Pentalon/KindlePageturner/Pics/Tastenpad und Spannungteiler.jpg

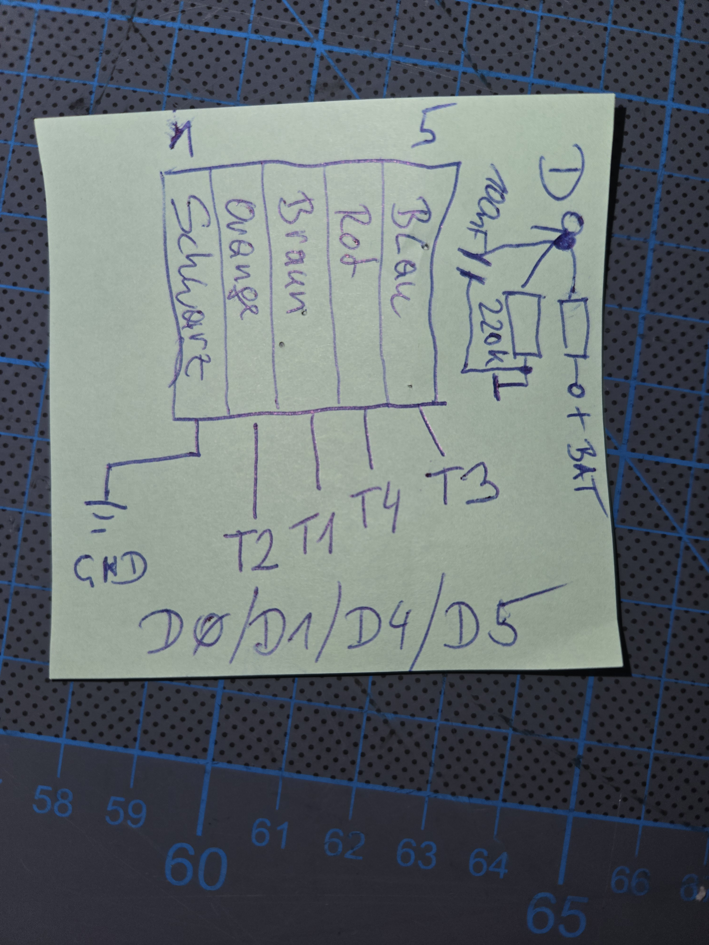
Pics/Tastenpad und Spannungteiler.jpg
