Pentalon/KindlePageturner/Pics/Im Gehäuse.jpg

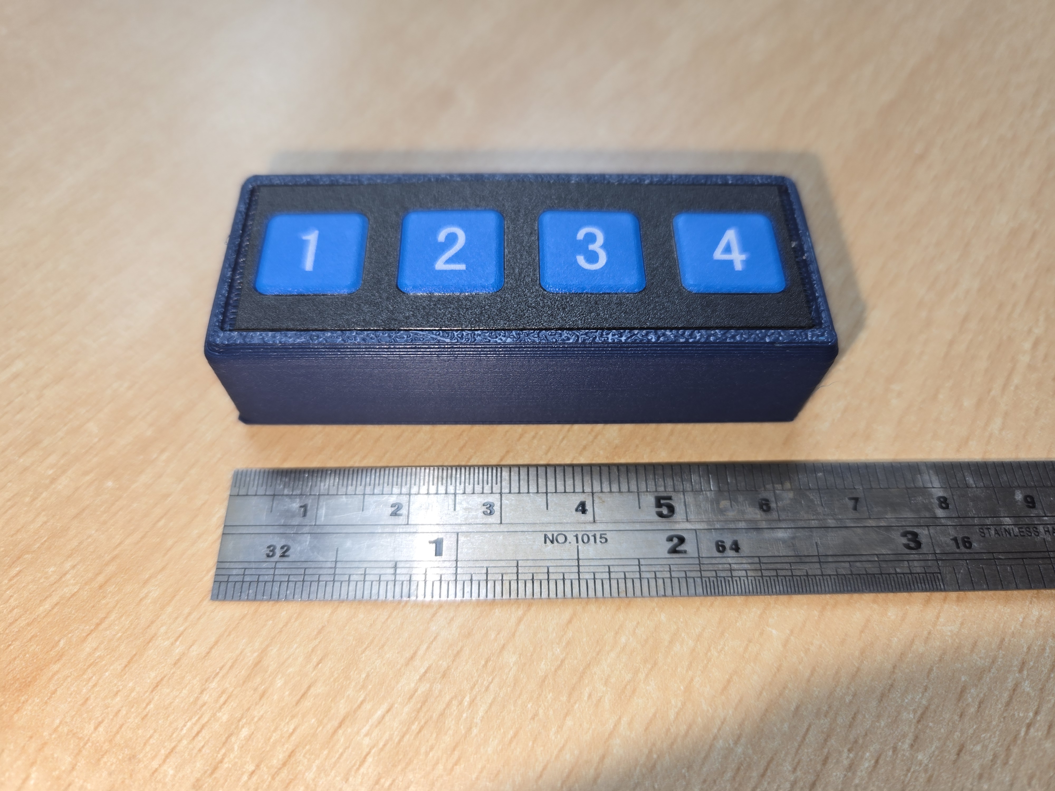
Pics/Im Gehäuse.jpg
