Pentalon/KindlePageturner/Pics/Im Gehäuse 2.jpg

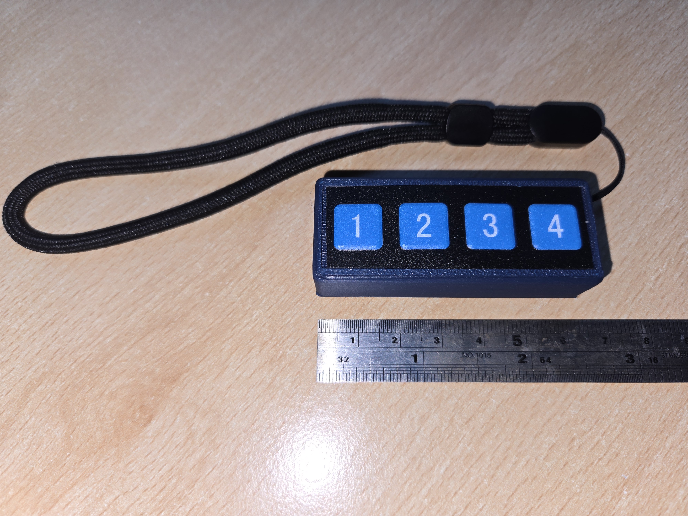
Pics/Im Gehäuse 2.jpg
