Pentalon/KindlePageturner/Pics/Kindle Klick klein (300mA) und gross (3700mA).jpg

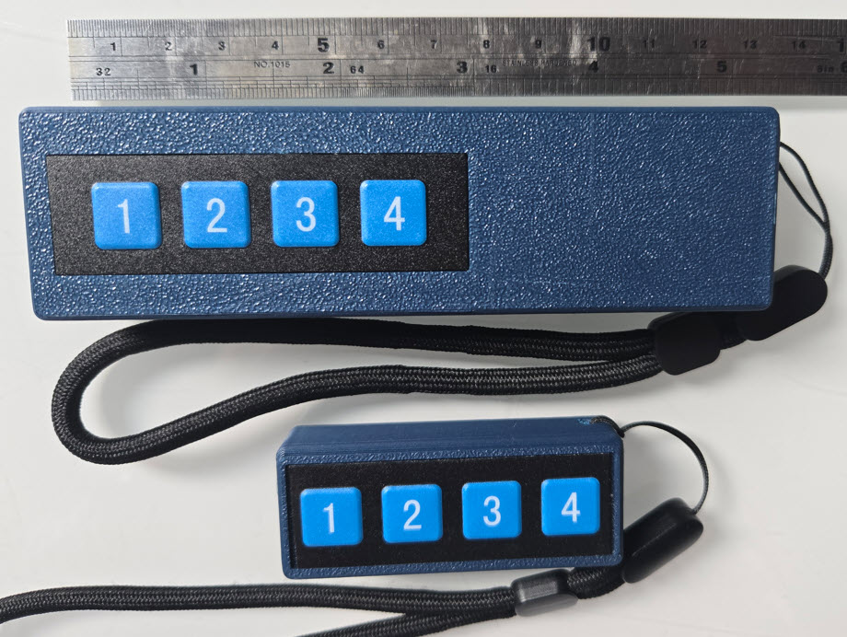
Pics/Kindle Klick klein (300mA) und gross (3700mA).jpg
