Pentalon/KindlePageturner/Pics/Ohne Gehäuse.jpg

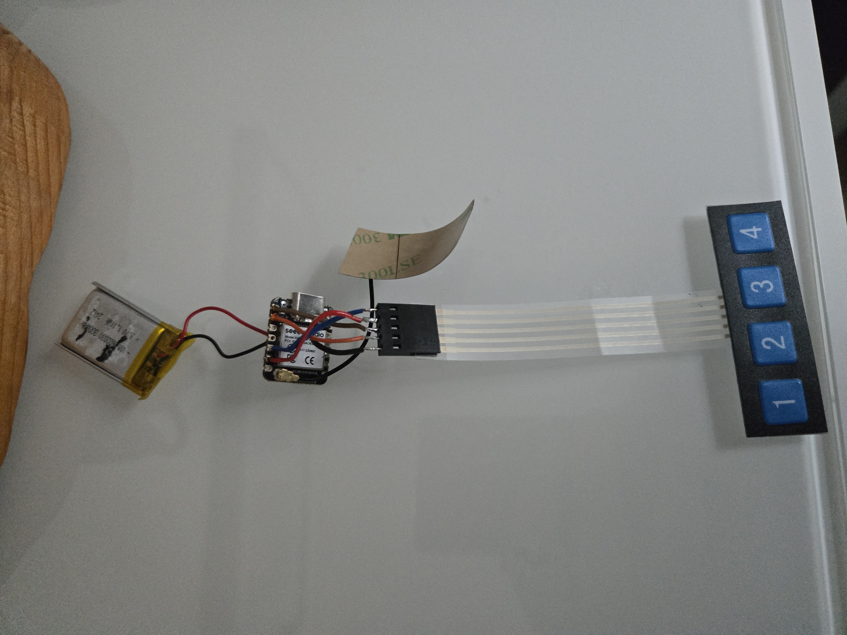
Pics/Ohne Gehäuse.jpg
