Pentalon/KindlePageturner/Pics/Pageturner Schaltplan.jpg

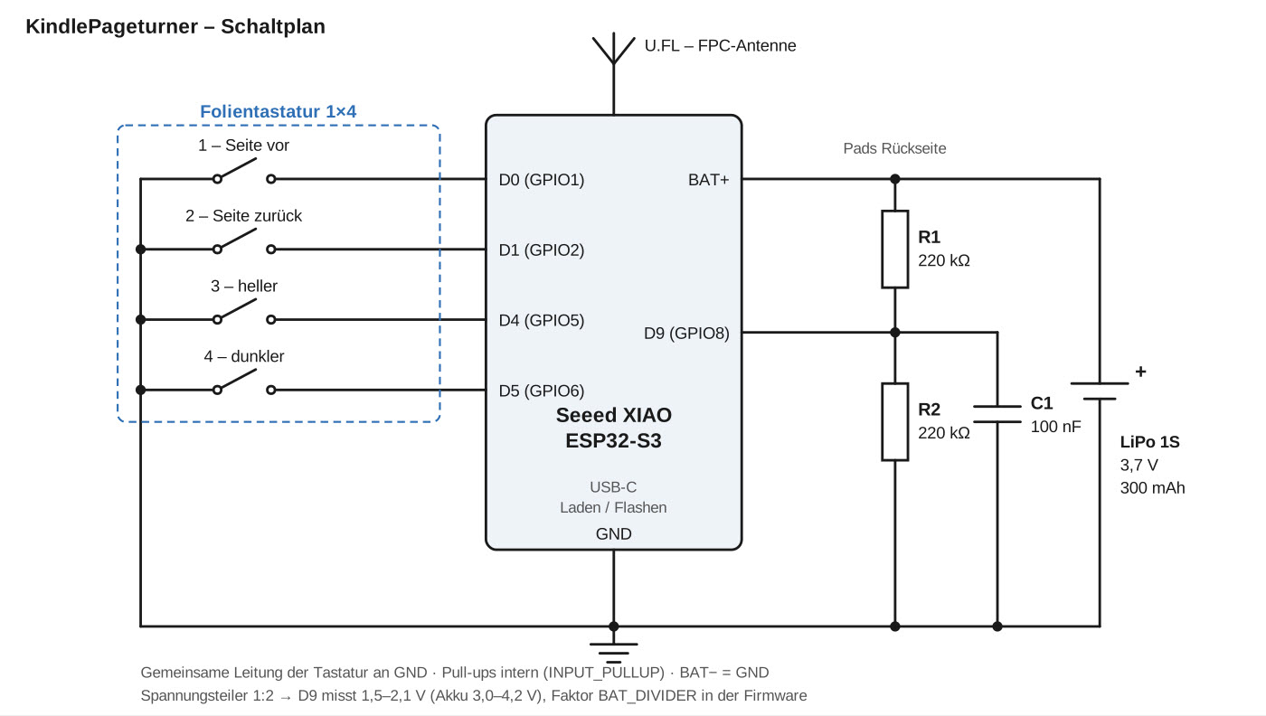
Pics/Pageturner Schaltplan.jpg
