Pentalon/KindlePageturner/Pics/Verkabelung.jpg

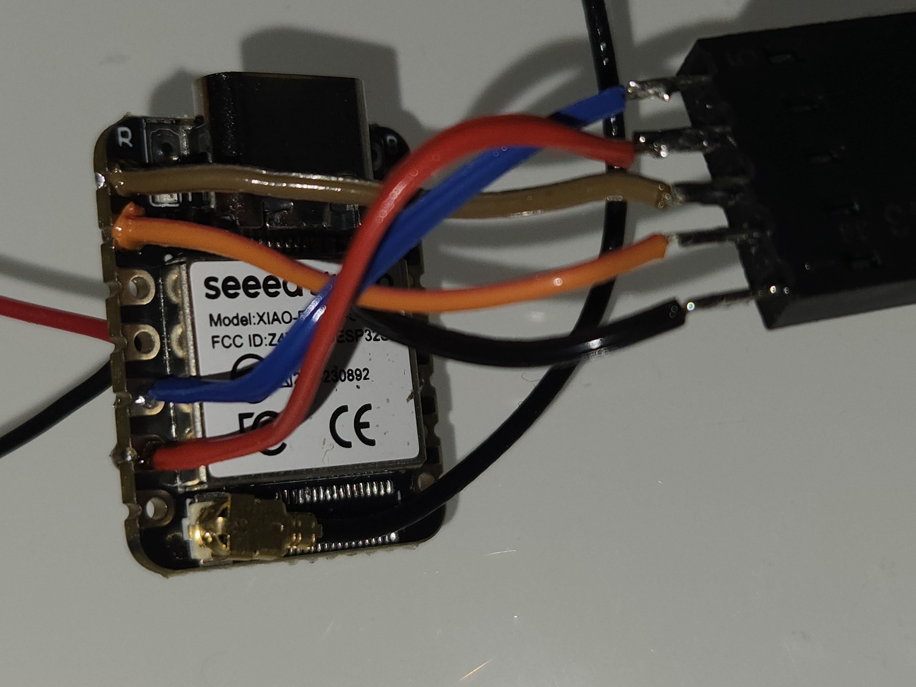
Pics/Verkabelung.jpg
