Pentalon/KindlePageturner/Cad/Kindle Pageturner 3700mA Gehäuse.STEP

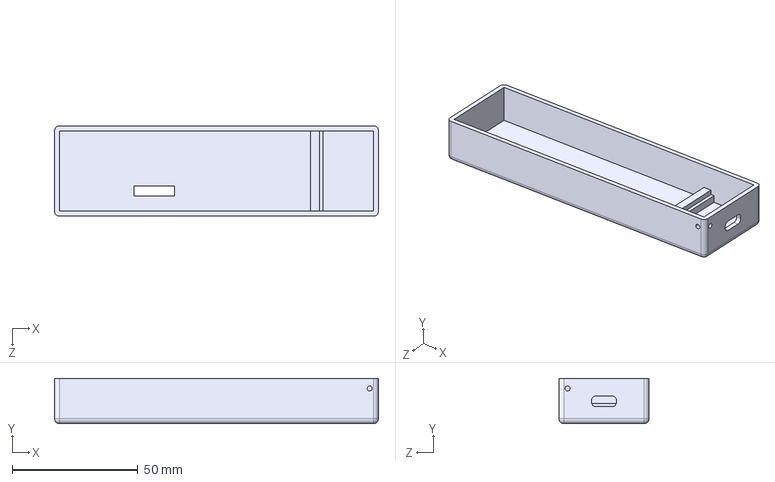
[picture p8: CAD file, 2026-11-07]
Cad/Kindle Pageturner 3700mA Gehäuse.STEP
129.0 x 18.0 x 36.0 mm
