Pentalon/KindlePageturner/Cad/Kindle Pageturner 3700mA.3mf

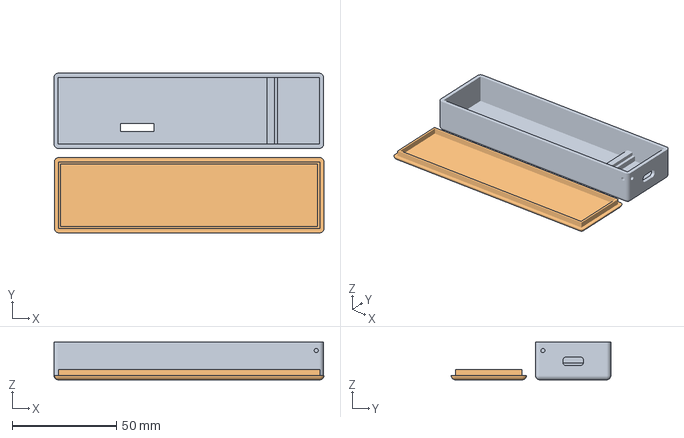
[picture p9: CAD file, 2026-11-07]
Cad/Kindle Pageturner 3700mA.3mf
129.2 x 76.4 x 18.0 mm
Kindle Pageturner 3700mA Deckel
