Pentalon/KindlePageturner/Cad/Kindle Pageturner 3700mA Deckel.STEP

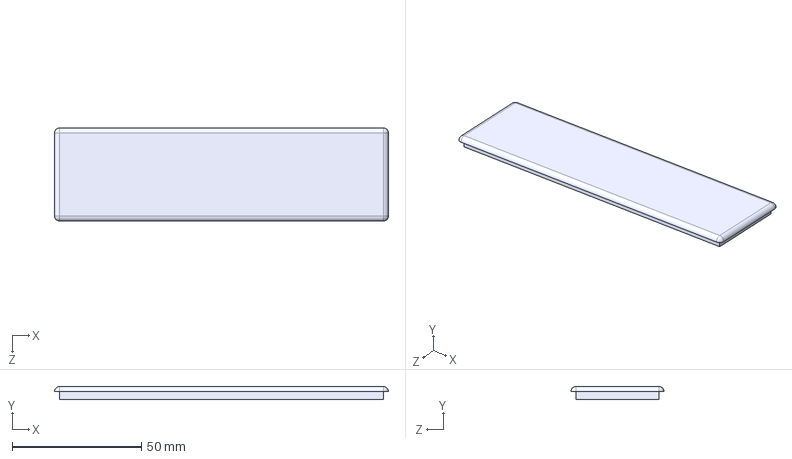
[picture p10: CAD file, 2026-11-07]
Cad/Kindle Pageturner 3700mA Deckel.STEP
129.0 x 5.00 x 36.0 mm
