Pentalon/KindlePageturner/Cad/Kindle Pageturner 300mA.3mf

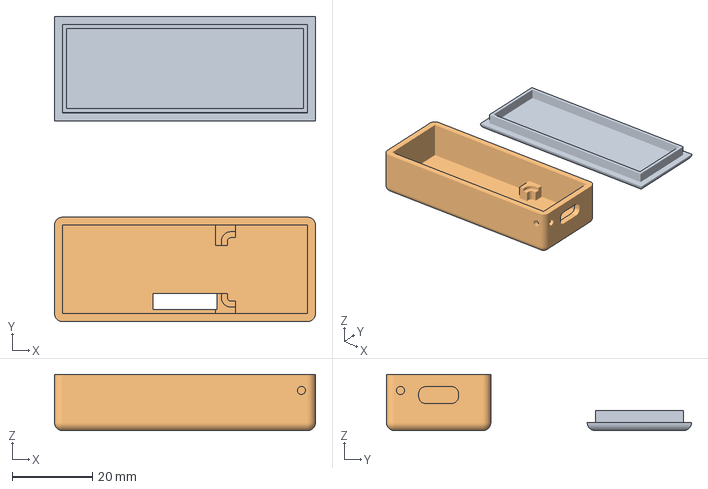
[picture p11: CAD file, 2026-10-25]
Cad/Kindle Pageturner 300mA.3mf
65.0 x 76.0 x 14.0 mm
Kindle Pageturner Deckel
