Pentalon/KindlePageturner/Cad/Kindle Pageturner 300mA Gehäuse.STEP

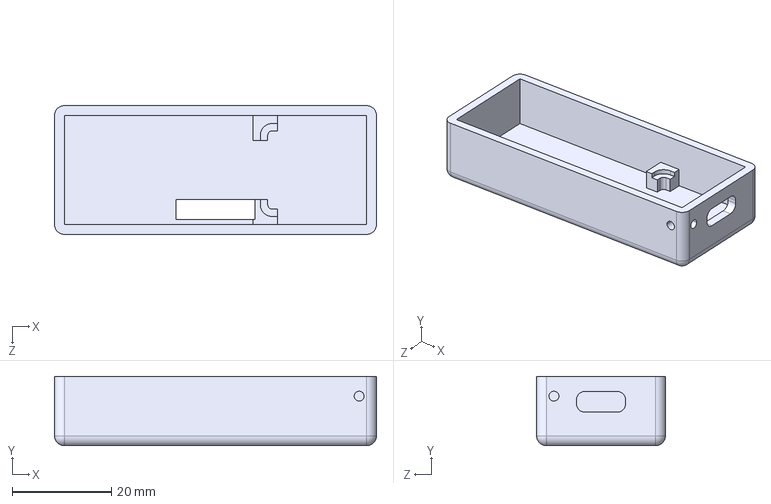
[picture p12: CAD file, 2026-10-25]
Cad/Kindle Pageturner 300mA Gehäuse.STEP
65.0 x 14.0 x 26.0 mm
