Pentalon/KindlePageturner/Cad/Kindle Pageturner 300mA Deckel.STEP

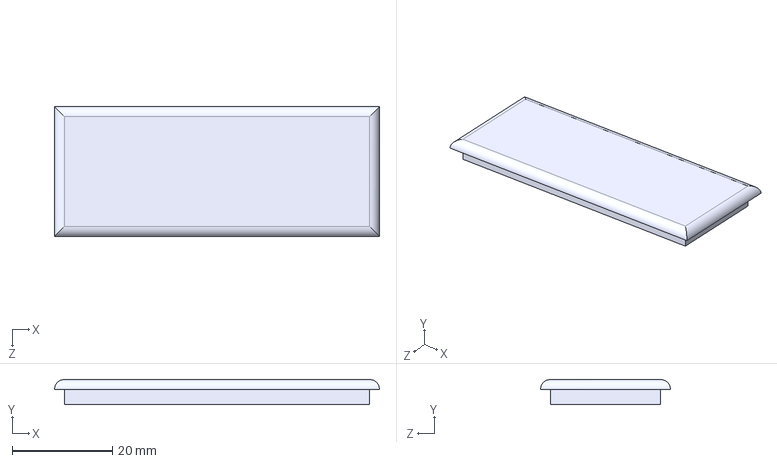
[picture p13: CAD file, 2026-10-24]
Cad/Kindle Pageturner 300mA Deckel.STEP
65.0 x 5.00 x 26.0 mm
