Pentalon/KindlePageturner/(commit log)

2026-10-21 Entwicklung und Test der SQ mit ESP32S3 Dev Board
2026-10-23 Umgestellt auf XIAO und Deep Sleep nach 5 Min
2026-10-24 STEP Gehäuse
    [Kindle Pageturner Deckel.STEP, Kindle Pageturner Gehäuse.STEP]
2026-10-24 Aktualisierte Readme
    [Kindle Pageturner Deckel.STEP, Kindle Pageturner Gehäuse.STEP]
2026-10-24 Neues Gehäuse mit Loch für Anhänger
    [Kindle Pageturner Deckel.STEP, Kindle Pageturner Gehäuse.STEP]
2026-10-24 Hinzugefügt 3mf Datei zum Drucken
    [Kindle Pageturner.3mf]
2026-10-24 Parts.md und docs/schematics hinzugefügt
2026-10-25 Gehäuse Loch für Anhänger tiefer gesetzt
    [Kindle Pageturner Gehäuse.STEP, Kindle Pageturner.3mf]
2026-11-05 CAD Files benannt nach Akkugröße
    [Kindle Pageturner 300mA Deckel.STEP, Kindle Pageturner 300mA Gehäuse.STEP, Kindle Pageturner 300mA.3mf]
2026-11-07 Gehäuse für 3700mA Akku Größe: 97 x 33.5 x 10,3
    300mA Akku hält ca 5 Tage, 3700mA Akku theoretisch 12x so lange, also ca 2 Monate !
    [Kindle Pageturner 3700mA Deckel.STEP, Kindle Pageturner 3700mA Gehäuse.STEP, Kindle Pageturner 3700mA.3mf]
